SmartEVSE/Sensorbox-2/Sensorbox2_ESP/HowToFlash.txt

-surf to http://your-smartevse/update
-select the firmware.bin from this archive, OR if you want the debug version (via telnet over your wifi),
 rename firmware.debug.bin to firmware.bin and select that. YOU CANNOT FLASH A FILE WITH ANOTHER NAME!
-if you get FAIL, check your wifi connection and try again;
-after OK, wait 10-30 seconds and your new firmware including the webserver should be online!
