SmartEVSE/Sensorbox-2/(threads)

Thread 1 (2021-04-01):

LED blinks gree when power is taken from the grid

PA1RB, 2021-04-01:
According to the description in the [webshop](https://www.stegen.com/en/ev-products/129-smart-evse-sensorbox-v2.html):

> Furthermore, the Sensorbox has a status LED, which blinks orange when power is taken from the grid, or green when it feed back to the grid.

However, the LED blinks green in my case, I do not have solar panels.
Gris consumtion reading on the connected SmartEVSE controller is correct.
Sensorbox is connected to the P1 port of the smart meter.

mstegen, 2021-04-01:
If you use the P1 port of the smart meter, then the LED will always blink green, once every two seconds.

Only if you use CT's and the Voltage (mains) input, the LED will blink orange or green, three times (once for each phase) every two seconds.
Orange is power from the grid.
Green is power feed back to the grid.

Thread 2 (2021-04-13):

Termination resistors on Modbus?

PA1RB, 2021-04-13:
The schematic of the SmartEVSE2 does not show termination resistors between A and B of the serial Modbus.

Distance between SmartEVSE and Sensorbox v2 in my case is appr. 50m and no problems in practice, but perhaps still a good idea to mount 100 Ohm termination resistors between A and B at both ends of the (Cat 5e) line?!

wbitholedotbe, 2021-05-19:
It's always a good idea... But it has to be 120 ohm.

Closed 2021-08-16.

Thread 3 (2021-08-12):

Schematics/firmware?

jimon, 2021-08-12:
Hi,

I think this repo either empty or all branches hidden.
So any schematics and firmware available for v2?
Thanks!

dries007, 2021-08-24:
I second this request. I might like to add some additional features so I don't need another device attached to the P1 bus.

mstegen, 2021-08-29:
Schematic and standard firmware files are now available.

dries007, 2021-08-29:
Can you write up somewhere what modbus registers are available in the current firmware?

mstegen, 2021-08-30:
Just added the explanation of the modbus registers to the Readme, and some examples.
Please note that you can only read all the mobus registers at once. You can not request a specific register.

When using the CT inputs, you can also set the Grid setting from 4 to 3 wires, and the field rotation from CW (clockwise) to CCW (counter clockwise).

IgorYbema, 2021-09-02:
Thanks for making the ESP32 code, the PIC firmware and the schematic available!
Are you also planning to release the PIC code? I was looking if it was possible to use P1 and CT together. P1 for the mains meter and CT for the EV charged meter.
Maybe it is possible with current PIC firmware (let the PIC do the CT and the ESP32 do the P1 as P1 seems to be connected to the ESP32 also)?

mstegen, 2021-09-02:
Yes, i'm cleaning up the code, and will make the code for the PIC available in a few days.

There will be two compile options, one normal, where the PIC handles everything (this is currently the way it's done).
The PIC will then handle the P1 data and the CT measurements, and communication over RS485. The ESP32 will only blink the LED ;-)

The other compile option will just do the CT measurements, and send the raw data to the ESP for further processing.
Here the ESP32 will handle the P1, and RS485 bus, and read the CT measurements data from the PIC (over a serial line).

All data from CT's+P1 port is already sent to the SmartEVSE, so if you want to use the CT measurements as EV meter, it might be easier to modify the SmartESVE code?

IgorYbema, 2021-09-02:
> All data from CT's+P1 port is already sent to the SmartEVSE, so if you want to use the CT measurements as EV meter, it might be easier to modify the SmartESVE code?

Ok great. Yes that would be more feasible.

WilfredHoogerbrugge, 2022-01-18:
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

Any progress on this?

It would be realy nice to have a 'smart' sensorbox that provides an API for home automation purposes and does all the modbus comminication so we don't have to bother with a multi-master modbus setup anymore.

mstegen, 2022-02-10:
Ok, a few days became a few months... But i've just uploaded the Sensorbox 2 code.

IgorYbema, 2022-02-10:
Thanks. A great progress forwards! So this is still sensorbox as slave as I understand. Are you planning to switch the master/slave task somewhere soon?

mstegen, 2022-02-10:
As the next SmartEVSE v3 also uses a ESP32, i'm planning on moving the code over to the sensorbox once it's working on the SmartEVSE.  Should probably hire someone to work on this, as there is a lot of stuff to do.

rob040, 2022-11-04:
@mstegen any progress in making the current sensorbox-2 PIC firmware available?

I'm curious on how often the current is sensed and if the phase difference is monitored, and if true-RMS current measurement being done. From the schematics, I gather the voltage is no measured, hence no power measurement is possible, only zero crossing of one phase is read. Are the CT phases checked/monitored by FW? On a household mains grid there could be there could be quite some harmonics in the CT signal, so the measurement frequency and anti-aliasing filtering can become important for decent CL1 results.
When using CT for measuring the current to the EV , in combination with P1-data, the phase voltages are known, so it could generate data about the power the EV actually takes. This would be an interesting use-case, and room for further improvements.

mstegen, 2022-11-04:
Hi @rob040,
I have just uploaded the PIC18F26K40 code. It can be used as stand alone, or in ESP_DIRECT mode.
In ESP_DIRECT mode it will not handle the modbus data, and only send raw data serially to the ESP32 for processing.

I can answer some of your questions. Each phase is sampled 60 times per second.
The phase is measured with the optocoupler, but voltage measurements are not possible this way, so i'm using a sine wave look up table as the 'voltage'. As i'm only interested in the currents on each phase (and not the power), this works out ok.

If the voltage lead is not connected, it will use a alternative way to calculate the current on each phase. (this is less precise for low currents, as the power factor is unknown)

WilfredH, 2022-11-17:
Thanks for sharing the new firmware.

In this new version the Sensorbox is still the modbus slave so the webserver is not of much use, it can only provide the P1 / CT measurements.
I was hoping for the Sensorbox to become an entry point for controlling the SmartEVSE via an webinterface/api but maybe I should give up and buy a V3 controller instead?

lhupfeldt, 2023-06-26:
I'm also hoping for controlling SmartEVSE V2 via the sensorbox, specifically just to toggle between Solar and Smart modes.

Thread 4 (2021-08-16):

Compatability with Smart Meter Fluvius

dries007, 2021-08-16:
Hey, has this box been tested with the smart meters that Fluvius uses (in Flanders)?
There are 2 models: Sagemcom S211 single phase en T211-D three phase.
I have the thee phase model here, so I can provide you with real packets if you need them.

I suspect it would work, because on the website, it lists Sagemcom T210-D as compatible, and mentions DSMR 5.
I know there is a small differance in the standards between NL and BE, namely that the current per phase is reported with 1 more didget of accuracy.

Thanks!

mstegen, 2021-08-16:
Yes, the Sensorbox2 works with the Sagemcom T211-D, but only when using a 4 wire(3Phase+Neutral) Grid.

dries007, 2021-08-16:
Thanks :)

Closed 2021-08-24.

Thread 5 (2021-12-26):

Procedure for firmware upgrade

kennyschuoler, 2021-12-26:
Current hardware ( bought in november 2021 ):
2x SmartEVSE v2.20
1x Sensorbox v2 ( with P1 and micro usb port )
1x Waveshare RS232485 to ETH to read the modbus data ( which can then be used in Home Assistant to visualize )

I have compiled and uploaded the master branch version to our SmartEVSE's ( v2.30+)
At first glance everything is working, but after a short while i have noticed that both SmartEVSE gave a "no communication error" , meaning they are not receiving signals from the Sensorbox.

I was also adding the setup into Home Assistant and was mapping the Modbus addresses to be able to visualize, and in the near future configure the settings. At first sight it seems that there are overlapping modbus addresses between the current Sensorbox v2 and the SmartEVSE v2.30+ ( 0x0000 , ... ) which i think in this case will be the cause of my problem. ( Which is  just an assumption )
I have read that there was a rewrite of the modbus register from v2.20 upwards ( which i could find in the source code ), but i could not find the changes related to the Sensorbox, or the upgrade procedure to update the firmware on the Sensorbox.

Is it correct that i still need to update the Sensorbox firmware in order to have a working setup with v2.30+ ?

As an alternative solution i tried using the SolarEdge Sunspec configuration, but this is also not a viable solution for me as address needs to be between 10 and 247, while our ID is currently configured at 2 + we only have 3 dipswitches ( so i'm not even able to configure a number higher than 10 )

Thanks !

kennyschuoler, 2021-12-26:
I also just tried connecting the SolarEdge SunSpec config, but there i also bump against the current fix; it's only possible to select the address starting from 10-247 ( while our ID is 2... )

bobosch, 2021-12-27:
Hi,

do you have configured one SmartEVSE as Master an one as Node 1 ?
If the master detects other traffic on the RS485 bus it stops sending modbus request for 4 seconds
https://github.com/SmartEVSE/SmartEVSE-2/commit/1f0bc9ffe44c02f13dfd7752a36b76c7062dc0f0
The message "Another modbus master detected" should written to the console.
After 10 seconds the error message "no communication" appears..

If you like to query the devices via modbus, set the request interval > 30 seconds.

Robert

kennyschuoler, 2022-01-11:
This seems to fix it indeed, thanks @bobosch !

Closed 2022-01-11.

Thread 6 (2022-01-23):

Next release?

PA1RB, 2022-01-23:
As I am considering programming features to allow HomeAssistant to influence the charging process, I thought it might be worth to ask the question first: _is the next version under active development, with a release planned in the coming weeks/months?_

@mstegen wrote:
I'll release a version of the PIC firmware soon that will only do the CT measurements, and will not use the RS485 bus, nor use the P1 port. On this version the ESP32 will handle everything else.

mstegen, 2022-01-24:
Yes, i'm actively working on both the next SmartEVSE v3 version as well as the Sensorbox 2 code.
Also adding a Wifi setup feature to the SmartESVE v2 code that allows you to connect the Sensorbox2 to the WiFi network.

mstegen, 2022-02-10:
@PA1RB I've just updated the Sensorbox 2 code.

Closed 2022-02-10.

Thread 7 (2022-10-28):

Some questions regarding Sensorbox 2

synegic, 2022-10-28:
Hello,

Some time ago I've installed the latest ESP32 version with WiFi enabled on my sensorbox v2. This worked for some time (could access web interface/WiFi connected) and the SmartEVSE communicated with the Sensorbox for P1 measurements, but after a while the SmartEVSE started to show 'NO COMM' error on its display. The Sensorbox ESP32 also seemed to have disappeared from my WiFI. After some further investigation, it seems the ESP32 does not want to boot anymore (serial output shows some CRC error on blocks from SPI flash). I guess the internal storage got corrupted.

I tried to create my own custom ESPHome-based firmware to at least take over the P1 communication part/integrate it better with home assistant, but this had the same issue. The ESP32 actually flashes a new firmware image without problems, and then boots into it once after the esptool resets it. But after that, any subsequent reboots it gets stuck in the CRC error boot loop again.

Now my questions;

1. is this particular ESP32 bricked and do I have to replace it? Or is there some special boot enablement code I have not found yet due to the way pins are pulled down/up during boot?
2. I see in documentation the pic is (re)programmed every boot. Isn't this wearing the PIC's programming flash? Or does it only flash if it sees the firmware is old? Does it actually function without this program on-boot or do I have to port this part to ESPHome as well?

My general goal would be to make a minimally viable version based on ESPHome that can communicate through modbus, work the P1 sensor data from DSRM meter and also read the CT clamps data. Then expose it through MQTT/Home Assistant API easily.

Hope you can help me with above.

Thanks!

Jorrit

synegic, 2022-10-29:
Nevermind, I actually got the ESP32 to work again. I was using some modbus library that was probably interfering with the chip's initialisation.

I'll see what I can get working in ESPHome.

mstegen, 2022-10-29:
Hi Synergic,
Glad you got it to work again.

ref point 2. The PIC is only reprogrammed when it finds a .hex file on the file system of the ESP32.
After programming the .hex file will be deleted, so it will only program it once.
The first version of the Sensorbox which used a PIC18F26K40, had everything in the PIC chip, the ESP32 was not doing anything other then blinking the led's.
So it is essential that you reprogram it otherwise it will interfere with the RS485 communication.
-Michael

synegic, 2022-10-30:
Hi @mstegen,

Thanks for your reply!

It seems the PIC is not doing anything on my Sensorbox. No serial communication seems to happen when I debug the incoming data on pin 23 (UART RX).

When I use the code inside the original Sensorbox firmware it detects an PIC16F1704. I do not see the bundled .hex file for flashing this chip, though.

How can I verify the PIC is actually doing it's job, or instruct it to start sending its data through UART so I can consume it on ESPHome?

Thanks in advance!

mstegen, 2022-10-31:
Ah, then you have the new hardware with the PIC16F1704. Here, the PIC sends it's measurement data through it's UART to the ESP32. The ESP32 does the final calculation for the CT measurements. And handles the RS485 communication.

You should be able to see the data coming in, every second or so.
The PGC pin is used to set the 3 wire/4 wire or phase rotation on the PIC.
Make sure that the PIC is not held in Reset.

synegic, 2022-10-31:
Thanks again. Just tried changing the code a bit.

I took the SetupPIC contents and traced the pinmode toggles from the main.cpp file on the original firmware. Put those into a custom component for ESPHome, which is initialised on ESP boot;

```
    void setup() override {
        RESET_OUTPUT;
        DAT_INPUT;
        CLK_INPUT;
        RESET_HIGH;

	pinMode(PIN_PGD, INPUT);
        pinMode(PIN_PGC, OUTPUT);

        ESP_LOGD("custom", "PIC has been enabled");
    }
```

But still no UART communication received from the PIC on pin 23;

```
uart:
  - id: uart_pic
    baud_rate: 115200
    tx_pin: 1
    rx_pin: 23
    debug:
      direction: RX
      dummy_receiver: false
      after:
        delimiter: "\n"
      sequence:
        - lambda: UARTDebug::log_string(direction, bytes);
```

Am I still missing something? Does the PIC need some time to boot? I do see a while loop that waits for Serial.begin() inside the main.cpp file.

synegic, 2022-10-31:
Sorry, I totally overlooked the fact that the PIC is terminating its serial communication with something else than a newline char. I got it to work now. Thanks a lot for your patience and help.

I will continue to try to port the full sensorbox code to ESPHome. I guess it's still a problem that the SmartEVSE is the master and not the sensorbox with regards to full control over the SmartEVSE's from this point of view.

My goal of the ESPHome based project is to utilise the Sensorbox for P1 readings (while also publishing the full DSMR data to my Home Assistant for energy monitoring purposes, just like the Slimmelezer project by Marcel Zuidwijk using their amazing dsmr ESPHome component https://esphome.io/components/sensor/dsmr.html?highlight=dsmr) but at the same time also use the CT clamp readings for monitoring my solar energy production separately. Then, use the gathered data to expose through modbus to the SmartEVSE master so I can remove the MQTT/Home Assistant/WiFi dependency for load balancing.

I'll keep you updated on my progress. Shouldn't be that hard to get something functional from here on forward.

mstegen, 2022-10-31:
Glad you got it to work!

You might have seen that the PIC data changes, depending if the mains cable is connected. When it's unconnected it will only do normal (rms) current measurements. When it's connected it will also take phase angle of each measurement, and thus can determine the direction of the current.

You might try running it stand alone, it can also be powered from the P1 ports power pin.
Although i have not tried this yet. It might not work, as the P1 port can only provide 500mA @ 5V.

Yes please keep me updated on your progress.

Mawverick, 2023-11-09:
Another question regarding Sensorbox 2.0.
Does the sensorbox 2.0 built based on PIC16F1704 can work it stand alone without ESP same as it is with older PIC18F26K40.

mstegen, 2023-11-10:
No the PIC16F in the Sensorbox 2 can not work stand alone, the ESP32 is used for the communication and calculations.
A stand alone version is the Sensorbox plus, but it can only do CT measurements.

Mawverick, 2023-11-10:
CT measurements handle by PIC16F would be sueficent feature. Determine of current direction is another benefit . Does the code for PIC16F stand alone version also avaliable for communy?

arpiecodes, 2023-11-10:
> CT measurements handle by PIC16F would be sueficent feature. Determine of current direction is another benefit . Does the code for PIC16F stand alone version also avaliable for communy?

Could you explain a bit more what your goal is to do? If you put code on the ESP32 in the Sensorbox, it can communicate with the PIC through serial port and retrieve those measurements.

Closed 2022-10-29.

Thread 10 (2023-01-06):

Binary files in releases?

henriterhofte, 2023-01-06:
Can you include binary files in releases? This would help deploying firmware to the Sensorbox-2 without the need to compile the firmware and/or when there is a problem during firmware compilation (see e.g. issue

Including the bin files similar to [https://github.com/SmartEVSE/SmartEVSE-3/releases/tag/v3.0.1](https://github.com/SmartEVSE/SmartEVSE-3/releases/tag/v3.0.1) might already be enough.

Incuding firmware deployment instructions similar to the way we [do it for our Twomes ESP32 measurement devices](https://www.energietransitiewindesheim.nl/twomes-generic-esp-firmware/deploying/device-preparation/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) might even help a bit more.

Deployment could then be done with a statement similar to the one below, albeit with different hex addresses for the various partitions.
```
py -m esptool --chip esp32 --baud 460800 --before default_reset --after hard_reset write_flash -z --flash_mode dio --flash_freq 40m --flash_size detect 0x1000 bootloader.bin 0x18000 partitions.bin 0x1d000 ota_data_initial.bin 0x20000 firmware.bin````

Thread 9 (2023-01-06):

Buid.link error: bad value

henriterhofte, 2023-01-06:
I got a `bad value` error while during linking `firmware.elf` after cloning this repo yesterday, doing a 'clean all'  and building this repo using Visual Studio Code (v1.74.2), PlatformIO (Core: 6.1.5; Home 3.4.3) and Windoes 11 Education (v21H2). I also get the same error when I change the platform line in platromio.ini to espressif32. Similarly, I also get the same error when compiling the [source code in the v2.0.0 release](https://github.com/SmartEVSE/Sensorbox-2/releases/tag/v2.0.0).

What could be the problem here?

```
CONFIGURATION: https://docs.platformio.org/page/boards/espressif32/esp32dev.html
PLATFORM: Espressif 32 (3.3.1+sha.33ff413) > Espressif ESP32 Dev Module
HARDWARE: ESP32 240MHz, 320KB RAM, 4MB Flash
DEBUG: Current (esp-prog) External (esp-prog, iot-bus-jtag, jlink, minimodule, olimex-arm-usb-ocd, olimex-arm-usb-ocd-h, olimex-arm-usb-tiny-h, olimex-jtag-tiny, tumpa)
PACKAGES:
 - framework-arduinoespressif32 @ 0.0.0+sha.caef400
 - tool-esptoolpy @ 1.30200.211025 (3.2.0)
 - toolchain-xtensa-esp32 @ 8.4.0+2021r1
LDF: Library Dependency Finder -> https://bit.ly/configure-pio-ldf
LDF Modes: Finder ~ chain, Compatibility ~ soft
```
...
```
Linking .pio\build\release\firmware.elf
c:/users/henrgi/.platformio/packages/toolchain-xtensa32/bin/../lib/gcc/xtensa-esp32-elf/8.4.0/../../../../xtensa-esp32-elf/bin/ld.exe: final link failed: bad value
collect2.exe: error: ld returned 1 exit status
*** [.pio\build\release\firmware.elf] Error 1

```
I also tried the solution mentioned in [SmartEVSE-3/issues/36](https://github.com/SmartEVSE/SmartEVSE-3/issues/36), but that did not help either:

```
CONFIGURATION: https://docs.platformio.org/page/boards/espressif32/esp32dev.html
PLATFORM: Espressif 32 (3.3.1+sha.33ff413) > Espressif ESP32 Dev Module
HARDWARE: ESP32 240MHz, 320KB RAM, 4MB Flash
DEBUG: Current (esp-prog) External (esp-prog, iot-bus-jtag, jlink, minimodule, olimex-arm-usb-ocd, olimex-arm-usb-ocd-h, olimex-arm-usb-tiny-h, olimex-jtag-tiny, tumpa)
PACKAGES:
 - framework-arduinoespressif32 @ 0.0.0+sha.caef400
 - tool-esptoolpy @ 1.30200.211025 (3.2.0)
 - toolchain-xtensa-esp32 @ 8.4.0+2021r1
LDF: Library Dependency Finder -> https://bit.ly/configure-pio-ldf
LDF Modes: Finder ~ chain, Compatibility ~ soft
```...
```
Linking .pio\build\release\firmware.elf
c:/users/henrgi/.platformio/packages/toolchain-xtensa32/bin/../lib/gcc/xtensa-esp32-elf/8.4.0/../../../../xtensa-esp32-elf/bin/ld.exe: final link failed: bad value
collect2.exe: error: ld returned 1 exit status
*** [.pio\build\release\firmware.elf] Error 1
```

mstegen, 2023-01-06:
This does not look correct:
framework-arduinoespressif32 @ 0.0.0+sha.caef400

when i update the platformio.ini file to the latest arduino version, this is the output:

```PACKAGES:
 - framework-arduinoespressif32 @ 3.20006.221224 (2.0.6)
 - tool-esptoolpy @ 1.40400.0 (4.4.0)
 - toolchain-xtensa-esp32 @ 8.4.0+2021r2-patch5
LDF: Library Dependency Finder -> https://bit.ly/configure-pio-ldf
LDF Modes: Finder ~ chain, Compatibility ~ soft
Found 43 compatible libraries
Scanning dependencies...
Dependency Graph
|-- AsyncTCP-esphome @ 2.0.0
|-- ESPAsyncWebServer-esphome @ 3.0.0
|   |-- AsyncTCP-esphome @ 2.0.0
|   |-- FS @ 2.0.0
|   |-- WiFi @ 2.0.0
|-- ESPAsync_WiFiManager @ 1.9.8
|   |-- ESP Async WebServer @ 1.2.3
|   |   |-- FS @ 2.0.0
|   |   |-- AsyncTCP-esphome @ 2.0.0
|   |   |-- WiFi @ 2.0.0
|   |-- ESP_DoubleResetDetector @ 1.2.1
|   |-- DNSServer @ 2.0.0
|   |   |-- WiFi @ 2.0.0
|   |-- WiFi @ 2.0.0
|-- eModbus @ 1.6.0
|   |-- AsyncTCP-esphome @ 2.0.0
|-- ESP Async WebServer @ 1.2.3
|   |-- FS @ 2.0.0
|   |-- AsyncTCP-esphome @ 2.0.0
|   |-- WiFi @ 2.0.0
|-- ESPmDNS @ 2.0.0
|   |-- WiFi @ 2.0.0
|-- Preferences @ 2.0.0
|-- SPIFFS @ 2.0.0
|   |-- FS @ 2.0.0
|-- Update @ 2.0.0
|-- WiFi @ 2.0.0
|-- FS @ 2.0.0
Building in release mode
```

Try deleting the files in the .pio folder, this will let platformio re-download packages

here is my current platformio.ini file for this project:
```[platformio]
description = Sensorbox 2 with web interface
default_envs = release

[env]
platform = espressif32
board = esp32dev
framework = arduino
upload_port = COM5
monitor_port = COM5
monitor_speed = 115200
upload_speed = 2000000
board_build.f_flash = 80000000L
board_build.flash_mode = dio
lib_ignore =
	AsyncTCP
	LittleFS_esp32
	Hash
	ESP8266WiFi
lib_deps =
	esphome/AsyncTCP-esphome @ 2.0.0
	esphome/ESPAsyncWebServer-esphome @ 3.0.0
	khoih-prog/ESPAsync_WiFiManager@1.9.8
	miq19/eModbus @ 1.6.0

monitor_filters = esp32_exception_decoder
board_build.partitions = partitions_custom.csv

[env:release]
build_flags =
	-DLOG_LEVEL=5
```

henriterhofte, 2023-01-08:
Short:
Your platformio.ini file (with `[platformio]` added as a first line) resolves the `framework-arduinoespressif32 @ 0.0.0+sha.caef400` error, but now I'm stuck with the missing bootloader error, which was also reported in [issue 36](https://github.com/SmartEVSE/SmartEVSE-3/issues/36).

I seems your esptool.py  (4.4.0) is much more recent than mine (3.1.0)... could this be the culprit? I

In more detail.
Deleting the files in the .pio folder seems to have the same effect as usung the 'Clean All' option in the left PlatformIO menu in VSCode:
```
 *  Executing task: C:\Users\henrgi\.platformio\penv\Scripts\platformio.exe run --target cleanall --environment release

Processing release (platform: espressif32; board: esp32dev; framework: arduino)
---------------------------------------------------------------------------------------------------------------------------------------------
Removing .pio\build\release
Removing .pio\libdeps\release
Done cleaning
======================================================== [SUCCESS] Took 0.76 seconds ========================================================
 *  Terminal will be reused by tasks, press any key to close it.

```

After changing the platformio.ini file to this content:
```
; PlatformIO Project Configuration File
;
;   Build options: build flags, source filter
;   Upload options: custom upload port, speed and extra flags
;   Library options: dependencies, extra library storages
;   Advanced options: extra scripting
;
; Please visit documentation for the other options and examples
; https://docs.platformio.org/page/projectconf.html

[platformio]
description = Sensorbox 2 with web interface
default_envs = release

[env]
platform = espressif32
board = esp32dev
framework = arduino
upload_port = COM5
monitor_port = COM5
monitor_speed = 115200
upload_speed = 2000000
board_build.f_flash = 80000000L
board_build.flash_mode = dio
lib_ignore =
	AsyncTCP
	LittleFS_esp32
	Hash
	ESP8266WiFi
lib_deps =
	esphome/AsyncTCP-esphome @ 2.0.0
	esphome/ESPAsyncWebServer-esphome @ 3.0.0
	khoih-prog/ESPAsync_WiFiManager@1.9.8
	miq19/eModbus @ 1.6.0

monitor_filters = esp32_exception_decoder
board_build.partitions = partitions_custom.csv

[env:release]
build_flags =
	-DLOG_LEVEL=5
```

The proper arduino framework seems to be used, i.e.  `framework-arduinoespressif32 @ 2.0.6+sha.57b27cd`...

However, I get the error `*** [.pio\build\release\bootloader.bin] Source `C:\Users\henrgi\.platformio\packages\framework-arduinoespressif32\tools\sdk\esp32\bin\bootloader__80m.elf' not found, needed by target `.pio\build\release\bootloader.bin'.`

More details:
```
 *  Executing task: C:\Users\henrgi\.platformio\penv\Scripts\platformio.exe run --environment release

Processing release (platform: espressif32; board: esp32dev; framework: arduino)
---------------------------------------------------------------------------------------------------------------------------------------------
Library Manager: Installing esphome/AsyncTCP-esphome @ 2.0.0
Unpacking  [####################################]  100%
Library Manager: AsyncTCP-esphome@2.0.0 has been installed!
Library Manager: Installing esphome/ESPAsyncWebServer-esphome @ 3.0.0
Unpacking  [####################################]  100%
Library Manager: ESPAsyncWebServer-esphome@3.0.0 has been installed!
Library Manager: Resolving dependencies...
Library Manager: Installing khoih-prog/ESPAsync_WiFiManager @ 1.9.8
Unpacking  [####################################]  100%
Library Manager: ESPAsync_WiFiManager@1.9.8 has been installed!
Library Manager: Resolving dependencies...
Library Manager: Installing me-no-dev/AsyncTCP @ >=1.1.1
Unpacking  [####################################]  100%
Library Manager: AsyncTCP@1.1.1 has been installed!
Library Manager: Installing me-no-dev/ESP Async WebServer @ >=1.2.3
Unpacking  [####################################]  100%
Library Manager: ESP Async WebServer@1.2.3 has been installed!
Library Manager: Resolving dependencies...
Library Manager: Installing khoih-prog/ESP_DoubleResetDetector @ >=1.2.1
Unpacking  [####################################]  100%
Library Manager: ESP_DoubleResetDetector@1.3.2 has been installed!
Library Manager: Installing lorol/LittleFS_esp32 @ >=1.0.6
Unpacking  [####################################]  100%
Library Manager: LittleFS_esp32@1.0.6 has been installed!
Library Manager: Installing miq19/eModbus @ 1.6.0
Unpacking  [####################################]  100%
Library Manager: eModbus@1.6.0 has been installed!
Library Manager: Resolving dependencies...
Library Manager: Installing git+https://github.com/maxgerhardt/Ethernet.git
git version 2.36.1.windows.1
Cloning into 'C:\Users\henrgi\.platformio\.cache\tmp\pkg-installing-71oiexs7'...
remote: Enumerating objects: 47, done.
remote: Counting objects: 100% (47/47), done.
remote: Compressing objects: 100% (40/40), done.
remote: Total 47 (delta 4), reused 19 (delta 0), pack-reused 0
Receiving objects: 100% (47/47), 52.74 KiB | 7.53 MiB/s, done.
Resolving deltas: 100% (4/4), done.
Library Manager: custom-Ethernet@2.0.0+sha.c9399a9 has been installed!
Verbose mode can be enabled via `-v, --verbose` option
CONFIGURATION: https://docs.platformio.org/page/boards/espressif32/esp32dev.html
PLATFORM: Espressif 32 (3.3.1+sha.33ff413) > Espressif ESP32 Dev Module
HARDWARE: ESP32 240MHz, 320KB RAM, 4MB Flash
DEBUG: Current (esp-prog) External (esp-prog, iot-bus-jtag, jlink, minimodule, olimex-arm-usb-ocd, olimex-arm-usb-ocd-h, olimex-arm-usb-tiny-h, olimex-jtag-tiny, tumpa)
PACKAGES:
 - framework-arduinoespressif32 @ 2.0.6+sha.57b27cd
 - tool-esptoolpy @ 1.30100.210531 (3.1.0)
 - toolchain-xtensa-esp32 @ 8.4.0+2021r1
LDF: Library Dependency Finder -> https://bit.ly/configure-pio-ldf
LDF Modes: Finder ~ chain, Compatibility ~ soft
Found 40 compatible libraries
Scanning dependencies...
Dependency Graph
|-- AsyncTCP-esphome @ 2.0.0
|-- ESPAsyncWebServer-esphome @ 3.0.0
|   |-- AsyncTCP-esphome @ 2.0.0
|   |-- FS @ 2.0.0
|   |-- WiFi @ 2.0.0
|-- ESPAsync_WiFiManager @ 1.9.8
|   |-- ESP Async WebServer @ 1.2.3
|   |   |-- FS @ 2.0.0
|   |   |-- AsyncTCP-esphome @ 2.0.0
|   |   |-- WiFi @ 2.0.0
|   |-- ESP_DoubleResetDetector @ 1.3.2
|   |-- DNSServer @ 2.0.0
|   |   |-- WiFi @ 2.0.0
|   |-- WiFi @ 2.0.0
|-- eModbus @ 1.6.0
|   |-- AsyncTCP-esphome @ 2.0.0
|-- ESP Async WebServer @ 1.2.3
|   |-- FS @ 2.0.0
|   |-- AsyncTCP-esphome @ 2.0.0
|   |-- WiFi @ 2.0.0
|-- ESPmDNS @ 2.0.0
|   |-- WiFi @ 2.0.0
|-- Preferences @ 2.0.0
|-- SPIFFS @ 2.0.0
|   |-- FS @ 2.0.0
|-- Update @ 2.0.0
|-- WiFi @ 2.0.0
|-- FS @ 2.0.0
Building in release mode
Compiling .pio\build\release\src\main.cpp.o
Compiling .pio\build\release\src\prg_pic.cpp.o
Compiling .pio\build\release\src\radix.cpp.o
*** [.pio\build\release\bootloader.bin] Source `C:\Users\henrgi\.platformio\packages\framework-arduinoespressif32\tools\sdk\esp32\bin\bootloader__80m.elf' not found, needed by target `.pio\build\release\bootloader.bin'.
======================================================== [FAILED] Took 33.12 seconds ========================================================

 *  The terminal process "C:\Users\henrgi\.platformio\penv\Scripts\platformio.exe 'run', '--environment', 'release'" terminated with exit code: 1.
 *  Terminal will be reused by tasks, press any key to close it.
```

henriterhofte, 2023-01-08:
I even uninstalled and re-installed PlatformIO and Visual Sutdio Code, but I got the same result as directly above.

henriterhofte, 2023-01-08:
After running the build command with the `--verbose` option added, i.e.
`C:\Users\henrgi\.platformio\penv\Scripts\platformio.exe run --verbose --environment release `
it becoms clear that the [FLASH mode option](https://docs.platformio.org/en/latest/platforms/espressif32.html#flash-mode) is not used in the toolchain, i.e. the  `board_build.flash_mode = dio` in the file `platformio.ini`  is not used by the toolchain when looking for the proper elf file.
The toolchain seems to depend on python; I am running
`Python 3.9.10 (tags/v3.9.10:f2f3f53, Jan 17 2022, 15:14:21)`

More details:
The linker is looking for `C:\Users\henrgi\.platformio\packages\framework-arduinoespressif32\tools\sdk\esp32\bin\bootloader__80m.elf`, which is not available in the folder.
The files that ARE available are:
```
Mode                 LastWriteTime         Length Name
----                 -------------         ------ ----
-a----          8-1-2023     19:27         721460 bootloader_dio_40m.elf
-a----          8-1-2023     19:27         721488 bootloader_dio_80m.elf
-a----          8-1-2023     19:27         721460 bootloader_dout_40m.elf
-a----          8-1-2023     19:27         721488 bootloader_dout_80m.elf
-a----          8-1-2023     19:27         737204 bootloader_qio_40m.elf
-a----          8-1-2023     19:27         737232 bootloader_qio_80m.elf
-a----          8-1-2023     19:27         737204 bootloader_qout_40m.elf
-a----          8-1-2023     19:27         737232 bootloader_qout_80m.elf
```

These files seem to have been copied from [https://github.com/espressif/arduino-esp32/tree/master/tools/sdk/esp32/bin](https://github.com/espressif/arduino-esp32/tree/master/tools/sdk/esp32/bin),

Just issuing the 'Build' command results in:

```
 *  Executing task: C:\Users\henrgi\.platformio\penv\Scripts\platformio.exe run --environment release

Processing release (platform: espressif32; board: esp32dev; framework: arduino)
-----------------------------------------------------------------------------------------------------------------------------------------------------
Verbose mode can be enabled via `-v, --verbose` option
CONFIGURATION: https://docs.platformio.org/page/boards/espressif32/esp32dev.html
PLATFORM: Espressif 32 (3.3.1+sha.33ff413) > Espressif ESP32 Dev Module
HARDWARE: ESP32 240MHz, 320KB RAM, 4MB Flash
DEBUG: Current (esp-prog) External (esp-prog, iot-bus-jtag, jlink, minimodule, olimex-arm-usb-ocd, olimex-arm-usb-ocd-h, olimex-arm-usb-tiny-h, olimex-jtag-tiny, tumpa)
PACKAGES:
 - framework-arduinoespressif32 @ 2.0.6+sha.57b27cd
 - tool-esptoolpy @ 1.40400.0 (4.4.0)
 - toolchain-xtensa-esp32 @ 8.4.0+2021r1
LDF: Library Dependency Finder -> https://bit.ly/configure-pio-ldf
LDF Modes: Finder ~ chain, Compatibility ~ soft
Found 40 compatible libraries
Scanning dependencies...
Dependency Graph
|-- AsyncTCP-esphome @ 2.0.0
|-- ESPAsyncWebServer-esphome @ 3.0.0
|   |-- AsyncTCP-esphome @ 2.0.0
|   |-- FS @ 2.0.0
|   |-- WiFi @ 2.0.0
|-- ESPAsync_WiFiManager @ 1.9.8
|   |-- ESP Async WebServer @ 1.2.3
|   |   |-- FS @ 2.0.0
|   |   |-- AsyncTCP-esphome @ 2.0.0
|   |   |-- WiFi @ 2.0.0
|   |-- ESP_DoubleResetDetector @ 1.3.2
|   |-- DNSServer @ 2.0.0
|   |   |-- WiFi @ 2.0.0
|   |-- WiFi @ 2.0.0
|-- eModbus @ 1.6.0
|   |-- AsyncTCP-esphome @ 2.0.0
|-- ESP Async WebServer @ 1.2.3
|   |-- FS @ 2.0.0
|   |-- AsyncTCP-esphome @ 2.0.0
|   |-- WiFi @ 2.0.0
|-- ESPmDNS @ 2.0.0
|   |-- WiFi @ 2.0.0
|-- Preferences @ 2.0.0
|-- SPIFFS @ 2.0.0
|   |-- FS @ 2.0.0
|-- Update @ 2.0.0
|-- WiFi @ 2.0.0
|-- FS @ 2.0.0
Building in release mode
Compiling .pio\build\release\src\main.cpp.o
Compiling .pio\build\release\src\prg_pic.cpp.o
Compiling .pio\build\release\src\radix.cpp.o
Building .pio\build\release\bootloader.bin
Generating partitions .pio\build\release\partitions.bin
usage: esptool elf2image [-h] [--output OUTPUT] [--version {1,2,3}]
                         [--min-rev-full {0, ... 65535}]
                         [--max-rev-full {0, ... 65535}] [--secure-pad]
                         [--secure-pad-v2]
                         [--elf-sha256-offset ELF_SHA256_OFFSET]
                         [--dont-append-digest] [--use_segments]
                         [--flash-mmu-page-size {64KB,32KB,16KB,8KB}]
                         [--flash_freq {80m,60m,48m,40m,30m,26m,24m,20m,16m,15m,12m}]
                         [--flash_mode {qio,qout,dio,dout}]
                         [--flash_size {256KB,512KB,1MB,2MB,2MB-c1,4MB,4MB-c1,8MB,16MB,32MB,64MB,128MB}]
                         [--spi-connection SPI_CONNECTION]
                         input
esptool elf2image: error: argument --flash_mode/-fm: expected one argument
Compiling .pio\build\release\libc95\AsyncTCP-esphome\AsyncTCP.cpp.o
Compiling .pio\build\release\libefe\FS\FS.cpp.o
Compiling .pio\build\release\libefe\FS\vfs_api.cpp.o
*** [.pio\build\release\bootloader.bin] Error 2
============================================================ [FAILED] Took 8.82 seconds ============================================================

 *  The terminal process "C:\Users\henrgi\.platformio\penv\Scripts\platformio.exe 'run', '--environment', 'release'" terminated with exit code: 1.
 *  Terminal will be reused by tasks, press any key to close it.
```

and indeed, after copying `bootloader_dio_80m.elf` to `bootloader__80m.elf` the error changes to an error in the arguments used for `esptool elf2image`  in the toolchain. Using the `--verbose option`, I can see that the following the `` -- flash_mode` is not followed by `dio`, which seems to cause the error

The crucial line is:
````
Building in release mode
"C:\Users\henrgi\.platformio\penv\Scripts\python.exe" "C:\Users\henrgi\.platformio\packages\tool-esptoolpy\esptool.py" --chip esp32 elf2image --flash_mode --flash_freq 80m --flash_size 4MB -o .pio\build\release\bootloader.bin C:\Users\henrgi\.platformio\packages\framework-arduinoespressif32\tools\sdk\esp32\bin\bootloader__80m.elf
```

henriterhofte, 2023-01-08:
The error may be related to this change, committed 2 days ago:
https://github.com/platformio/platform-espressif32/commit/d0835e994c2af374198cbdf976d6019dc7dafe5f

henriterhofte, 2023-01-08:
And indeed, changing the line that specifies the platform in `platformio.ini` to the line below finally allowed me to sucesfully complile and upload the Sensorbox-2 firmware!
```
platform = https://github.com/platformio/platform-espressif32.git#develop
````

So, it seems commit specified in https://github.com/platformio/platform-espressif32/commit/d0835e994c2af374198cbdf976d6019dc7dafe5f that is currently in the [develop](https://github.com/platformio/platform-espressif32/tree/develop) branch is needed to compile the firmware properly!?

henriterhofte, 2023-01-22:
The fix is incorporatedin release v6.0.0 of the espressif32 platform

So, after pulling v6.0.0 from GitHub, in platform.ini for the platfrm line, you can now simply use the line
`platform = espressif32`

and then the issue is gone.

mstegen, 2023-01-23:
Thanks for debugging this issue.
Just tried a fresh installation of Ubuntu + VScode + PlatformIO, and i ran into the same issue where the bootloader could not be found.

platform = espressif32 did not work for me.
Somehow it did not install the latest version, but instead installed framework-arduinoespressif32 @ 2.0.6 weird...

`platform = espressif32 @ 6.0.0`

did install the correct platform, framework and esptool

Thread 11 (2023-03-16):

Settings for AM550 electricity meter

crtg, 2023-03-16:
Hi,

our electricity provider is willing to enable power reading via P1 port on Iskraemeco AM550 electricity meter. However, we have to specify the format of the message and all other parameters.

Is it enough if I specify the DSMR v5, 115200 baud and the following telegram message?

DSMR version 5.0 1-3:0.2.8.255
Instantaneous voltage L1 1-0:32.7.0.255
Instantaneous voltage L2 1-0:52.7.0.255
Instantaneous voltage L3 1-0:72.7.0.255
Instantaneous active power L1 (+P) 1-0:21.7.0.255
Instantaneous active power L2 (+P) 1-0:41.7.0.255
Instantaneous active power L3 (+P) 1-0:61.7.0.255
Instantaneous active power L1 (-P) 1-0:22.7.0.255
Instantaneous active power L2 (-P) 1-0:42.7.0.255
Instantaneous active power L3 (-P) 1-0:62.7.0.255
Actual electricity power delivered (+P) in 1 Watt resolution 1-0:1.7.0.255
Actual electricity power received (-P) in 1 Watt resolution 1-0:2.7.0.255

Is there something else missing (IEC 62056 mode) in the electricity meter they need to set up in order to establish the communication with the Sensorbox-2?

Thanks, Crt

mstegen, 2023-03-16:
For the Sensorbox 2, this is enough information.
Although for your own use i would be nice if they could also add the other parameters like total energy delivered, and total energy received.

With a compatible telegram you could also run software like DSMR-reader:
https://dsmr-reader.readthedocs.io/en/v5/explained/about.html#

crtg, 2023-03-22:
Thanks for your answer. I can choose also the frequency of the message. Do you have any recommendation? Is 1Hz fast enough?

Thanks, Crt

mstegen, 2023-03-22:
Our smart meters send a P1 telegram every second, so yes i would choose 1Hz.

crtg, 2023-04-03:
Hi,

are you sure the cable from the meter is compliant also with Iskra AM550? Based on some public info it seems that the signal from EM550 is inverted.

Thanks, Črt

mstegen, 2023-04-11:
Yes, our house has a Iskra AM550 smart meter.

The P1 signal will be inverted again by the Sensorbox, you can set the ESP32 to invert the signal. (the previous sensorbox 2 had an extra transistor to invert the serial P1 data, before sending it to the PIC chip)

Thread 12 (2023-04-22):

Orange LED on sensorbox and "Error no serial" on SmartEVSE

lhupfeldt, 2023-04-22:
I just tried to replace my sensorbox v1 with sensorbox v2.

I got orange LED on sensorbox and "Error no serial" on SmartEVSE. I did not upgrade the SmartEVSE firmware yet (it is old with not SOLAR mode). Is it necessary to upgrade SmarEVSE firmware before using sensorbox v2?

bobosch, 2023-04-23:
Yes, but Sensorbox 1 won't work with the new firmware.

lhupfeldt, 2023-04-23:
Thank you @bobosch.
@mstegen It would be nice if this made clear in the documentation. If it is written somewhere, then I missed it.
I thought I could keep Sensorbox 1 as a spare, but probably not worth it if I need to downgrade firmware first.
