SmartEVSE/Sensorbox-2/schematic/Sensorbox2_v1.10.pdf

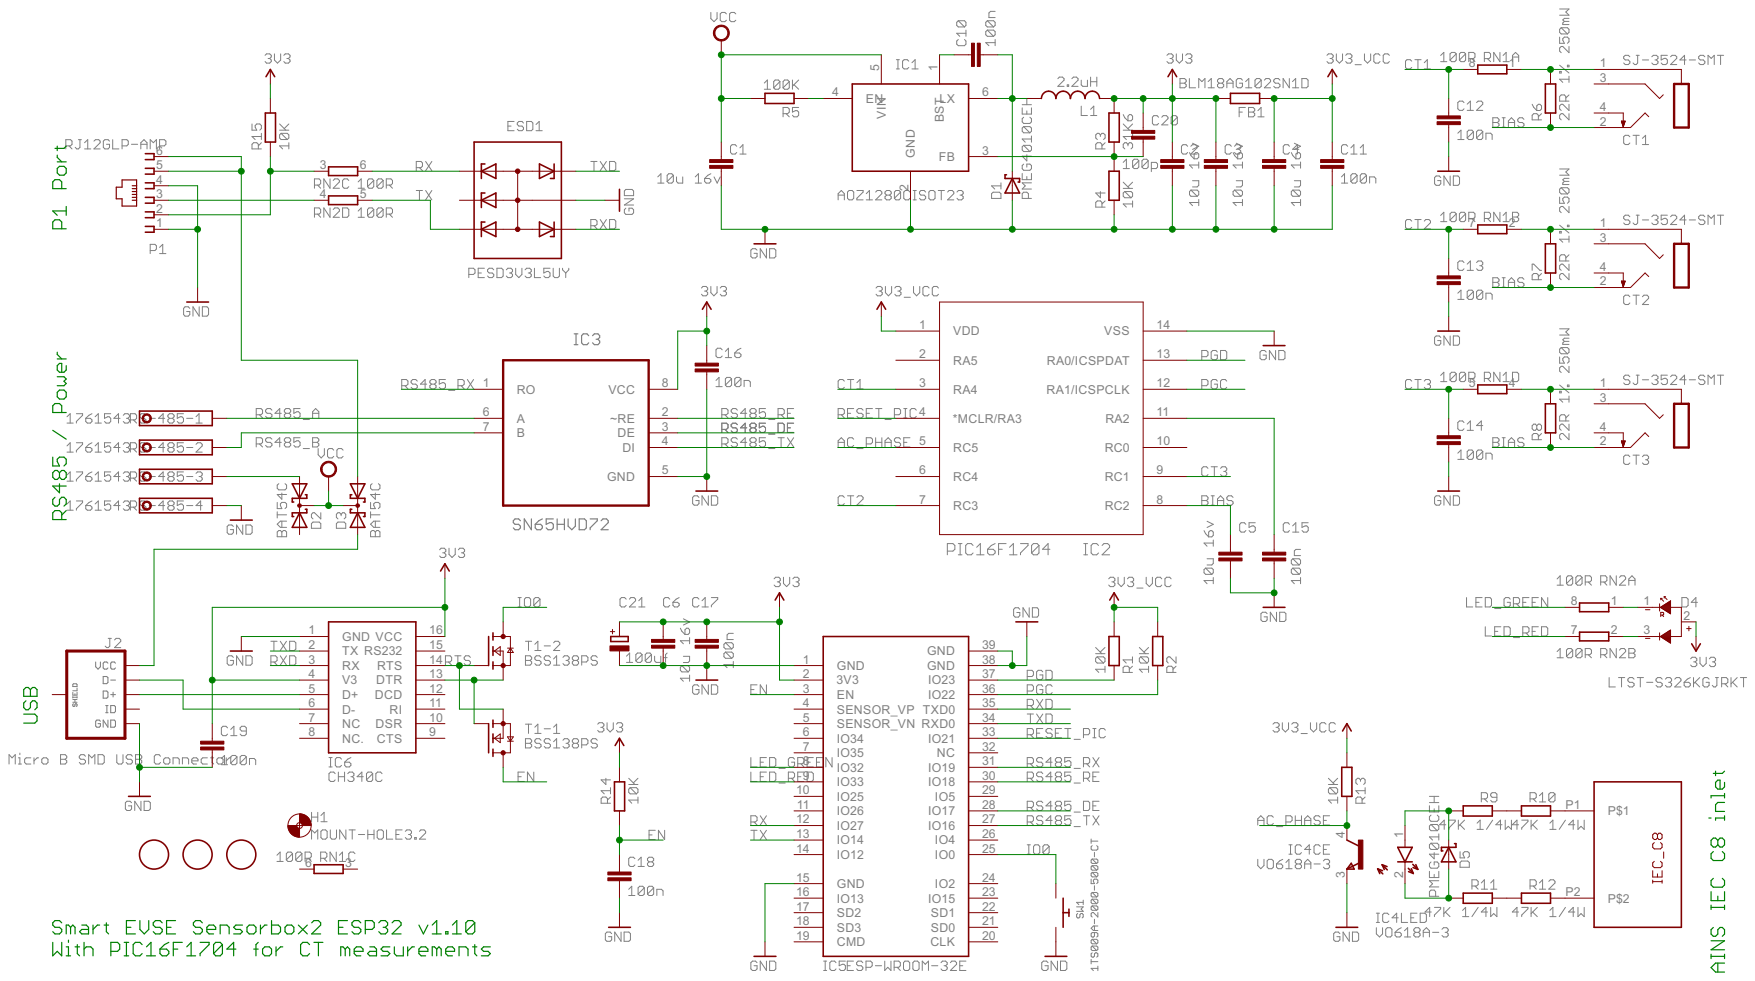
[picture p1: page 1]
