SmartEVSE/Sensorbox-2/schematic/Sensorbox2_v1.06.pdf

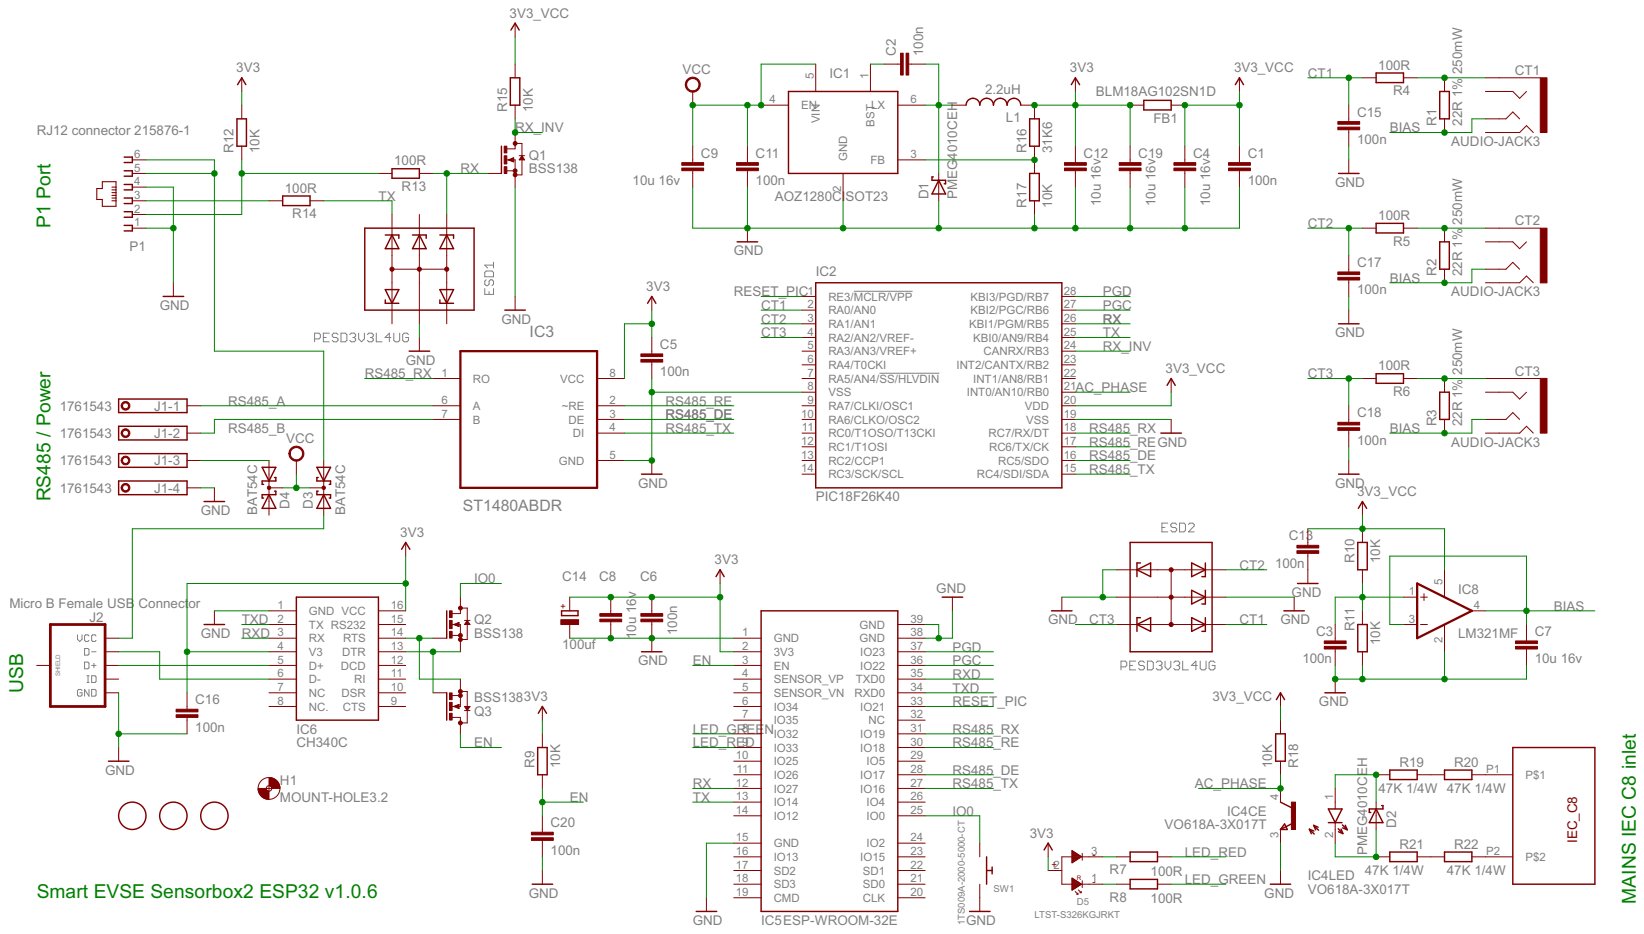
[picture p2: page 1]
