SmartEVSE/Sensorbox-2/Sensorbox2_ESP/src/radix.cpp

#include <Arduino.h>
//
// Convert a one character hex string to an uint8
//
uint8_t HexDec1(uint8_t c1) {
  if (c1>='A') c1-=7;
  c1-='0';
  return c1;
}


//
// Convert a two character hex string to an uint8
//
uint8_t HexDec2(uint8_t c1, uint8_t c2) {
  return HexDec1(c1)*16 + HexDec1(c2);
}


//
// Convert a four character hex string to an uint16
//
uint16_t HexDec4(uint8_t c1, uint8_t c2, uint8_t c3, uint8_t c4) {
  return HexDec2(c1,c2)*256 + HexDec2(c3,c4);
}

// read Mac, and reverse to ID
uint32_t MacId() {

  uint32_t id = 0;

  for (int i=0; i<17; i=i+8) {
    id |= ((ESP.getEfuseMac() >> (40 - i)) & 0xff) << i;
  }
  // on the ESP32 the low two bits are always zero.
  // so we do not use these bits in the ID.
  return id >> 2;         
}
