SmartEVSE/Sensorbox-2/(commit log)

2021-08-29 Sensorbox2 ESP firmware and schematic
    Sensorbox2 standard firmware and schematic
2022-02-10 P1 and Modbus handled by the ESP32. PIC only does CT measurements.
    [partitions_custom.csv]
2022-04-22 Added support for Sagemcom S211 Added hardware version 1.10 schematic
    [main.cpp]
2023-01-19 Added PIC16F1704 hex file
    Added PIC16F1704 hex file for use on v1.10 of the PCB
